konservs/esp-resso/docs/hardware.md

# Hardware

> ⚠️ This machine runs on **mains voltage** and holds **pressurised boilers near
> steam temperature**. Read [safety.md](safety.md) before wiring anything. The
> firmware is a *secondary* safety layer, never the only one.

## Overview

A dual-boiler E61 machine:

- **Brew boiler** (~93 °C) — espresso extraction.
- **Steam boiler** (~125 °C) — steam wand / hot water.
- **E61 group** — the lever mechanically opens the 3-way valve and trips a
  microswitch; the firmware does **not** drive a group valve.

## Bill of materials (core electronics)

| Qty | Part | Notes |
|----:|---|---|
| 1 | ESP32 dev module (WROOM-32) | Dual-core, classic ESP32 |
| 2 | MAX31865 RTD amplifier | One per boiler; 400 Ω precision reference for PT100 (`RTD_RREF` in `hal_esp32_temp.c` must match) |
| 2 | PT100 RTD probe | M4/M5 threaded or clamp, boiler temperature. **3-wire** — the firmware configures the MAX31865 to match (`RTD_WIRES` in `hal_esp32_temp.c`), and the board's RTDIN/FORCE jumpers must agree |
| 4 | Solid-state relay (zero-cross) | Boiler heaters — **two per boiler** (lower + upper element, ~400 W each), slow-PWM; DC-input, driven at 12 V via the ULN2003. Firmware runs at most 3 at once on a 120 V/15 A circuit — see the load guard in [control.md](control.md) |
| 1 | Pump + zero-cross SSR | **Ulka EFX5** vibratory (rated 2 min ON / 1 min OFF — firmware enforces the duty cycle, see [control.md](control.md)); zero-cross SSR enables pulse-skip flow. A rotary pump also fits — size the SSR for motor inrush |
| 2 | Mains solenoid valve (230/120 VAC) | Brew / steam auto-fill inlets; OEM Olab type (e.g. Profitec US1005) |
| 2 | 12 V relay (PCB, ≥ 250 VAC) | Switch each fill solenoid; optional RC/MOV across contacts |
| 1 | ULN2003A Darlington array | One low-side buffer for all actuators: 5 SSR inputs (4 heater elements + pump) + 2 relay coils = all 7 channels; COM→+12 V flyback |
| 1 | Flow meter (Hall, e.g. digmesa/gicar) | Volumetric dosing |
| 2 | Conductivity level probe | Brew + steam boilers (isolated AC-sensed) |
| 1 | Float switch | Reservoir low-water (reed/magnet) |
| 1 | 12 V DC PSU (≥ 1 A) | Main supply; logic + sensing + relay coils (fill valves are mains, relay-switched) — see [power.md](power.md) |
| 1 | Buck regulator 12→5 V | e.g. AP63205 / MP1584 — efficient bulk drop |
| 1 | LDO 5→3.3 V | e.g. AP2112K-3.3 — low-noise rail for ESP32 + RTDs |
| 1 | Isolated dual ±12 V DC-DC | e.g. Murata NMA1212 — **+12VA / GNDA / −12VA** for sensing (separate ground) |
| 1 | 74HC139 decoder | SELECT/ENABLE/REVERSE → 4 switch drives + shoot-through interlock (MCU side) |
| 1 | 74HC157 mux | SELECT routes active boiler's POS/NEG sense → 2 MCU pins (MCU side) |
| 8 | Optocoupler (PC817, V(CEO) ≥ 24 V) | 4× drive — decoder out, the opto *is* the ±12VA switch (no MOSFET) — + 4× sense (per boiler, per direction) |
| — | Current-limit resistors | ~4.7 kΩ per boiler (≈1–2 mA); see level-sensing.md |
| 1 | SSD1306 OLED, 128×64, I2C | Status display, address 0x3C |
| 1 | PCF8574 I2C expander | All buttons + switches (address 0x20); frees JTAG pins |
| 2 | Momentary push button | UI (A = −/left, B = +/right), to PCF8574 P0/P1 |
| 2 | Microswitch | E61 brew lever, steam knob, to PCF8574 P2/P3 |
| — | Thermal fuses, over-pressure valve | **Hardware** safety — see safety.md |

## GPIO map

Defined in [`components/drivers/include/drivers/pins.h`](../components/drivers/include/drivers/pins.h).
Change wiring there.

| Function | GPIO | Notes |
|---|-----:|---|
| SPI SCLK | 18 | Shared by both MAX31865 |
| SPI MOSI | 23 | |
| SPI MISO | 19 | |
| RTD brew CS | 5 | |
| RTD steam CS | 15 | Strapping pin, but CS idles high → boot-safe |
| I2C SDA | 21 | Shared: SSD1306 + PCF8574 |
| I2C SCL | 22 | Shared: SSD1306 + PCF8574 |
| SSR brew low | 26 | Active-high → ULN2003 → brew lower-element SSR; **R10** 10 kΩ pulldown |
| SSR brew high | 33 | Active-high → ULN2003 → brew upper-element SSR; **R22** 10 kΩ pulldown |
| SSR steam low | 25 | Active-high → ULN2003 → steam lower-element SSR; **R9** 10 kΩ pulldown |
| SSR steam high | 32 | Active-high → ULN2003 → steam upper-element SSR; **R17** 10 kΩ pulldown |
| Pump | 27 | Active-high → ULN2003 → pump SSR; **R16** 10 kΩ pulldown |
| Fill valve (brew) | 13 | Active-high → ULN2003 → fill relay; **R23** 10 kΩ pulldown |
| Fill valve (steam) | 4 | Active-high → ULN2003 → fill relay; **R24** 10 kΩ pulldown, and GPIO4 idles pulled-down internally → valve shut at boot |
| Flow meter | 34 | **Input-only**, needs external pull-up |
| Level SELECT | 16 | boiler select → 74HC139 A1 + 74HC157 sel |
| Level ENABLE | 17 | drive enable → 74HC139 Ē (active-low); **R11** 4.7 kΩ pull-up → drive idle-off at boot |
| Level REVERSE | 14 | polarity → 74HC139 A0; idles high at reset, harmless because R11 gates the decoder |
| Level sense + | 35 | **Input-only**, 74HC157 out (POS opto) |
| Level sense − | 36 | **Input-only**, 74HC157 out (NEG opto) |
| Level — reservoir | 39 | **Input-only**, float switch, external pull-up |

The UI buttons (A/B) and machine switches (brew lever, steam knob) are **not**
on native GPIOs — they hang off the PCF8574 I2C expander (below), which freed up
native pins. **GPIO 16/17/14** carry the level control lines
(SELECT/ENABLE/REVERSE); **GPIO 33** and **GPIO 32** drive the two upper
heater-element SSRs; the steam fill valve has **GPIO 4**. That leaves **GPIO 2**
(a strapping pin) as the only spare. (JTAG is not wired — see
[level-sensing.md](level-sensing.md).)

Pin choices here are driven as much by **reset pull state** as by function, since
every actuator is active-high through the ULN2003: GPIO 14/15 idle pulled *up*,
GPIO 2/4/12 idle pulled *down*, and 13/16/17/25/26/27/32/33 float. So the steam
fill valve sits on GPIO 4 (pulled down = shut at boot), while GPIO 14 — which
idles high — carries only level REVERSE, a logic input the decoder ignores while
R11 holds it disabled. See the caveats below.

### I2C input expander (PCF8574, address 0x20)

Eight active-low inputs on one chip, read over I2C alongside the OLED. Each pin
idles high on the expander's weak pull-up; the contact wires to GND. Bit map
lives in [`pins.h`](../components/drivers/include/drivers/pins.h) (`EXP_*`).

| Expander pin | Input | Notes |
|---|---|---|
| P0 | Button A (−) | UI left / minus |
| P1 | Button B (+) | UI right / plus |
| P2 | Brew lever switch | E61 paddle microswitch |
| P3 | Steam knob switch | Steam valve microswitch |
| P4–P7 | *spare* | Free for future buttons |

For more than 8 inputs, add a second expander at a different address.

### ESP32 pin caveats baked into the choices

- GPIO **34/35/36/39** are input-only and have **no internal pull resistors**, so
  any *passive* source on them needs an external pull. That applies to the flow
  meter (**R12**, 4.7 kΩ → 3.3 V) and the reservoir float switch (**R15**,
  4.7 kΩ → 3.3 V), both of which just close to GND. It does **not** apply to the
  level sense lines: GPIO 35/36 are fed by the 74HC157's push-pull CMOS outputs
  and are actively driven both ways. The 47 kΩ sense pull-ups (**R19/R18** brew,
  **R21/R20** steam) belong one stage earlier, on the opto collectors that feed the
  mux — see [level-sensing.md](level-sensing.md), where the value is set by
  sense-opto CTR rather than by anything the MCU needs.
- GPIO **0/2/5/12/15** are strapping pins and are avoided as driven outputs.
  GPIO 5 and 15 are used only as chip-selects (idle high), which is safe at boot.
  **GPIO 12**
  additionally selects the module's flash voltage and must be **low at reset**: it
  is left as a no-connect (the chip's internal pull-down holds it low → 3.3 V
  flash); an optional ~10 kΩ pull-down to GND adds margin. Never pull GPIO 12 high.
- **WROOM-32 module flash pins** — `SCK/SDO/SDI/SHD/SWP/SCS` (GPIO 6–11) are the
  module's internal SPI-flash bus, bonded to the flash die inside the can. **Leave
  them unconnected** (no-connect flags in the schematic, as verified); do not tie
  them to GND or route them anywhere, or the module won't boot / the flash can
  corrupt.
- **Every ULN2003 input carries a 10 kΩ pulldown to GND** — R9/R10/R17/R22
  (heaters), R16 (pump), R23/R24 (fill valves). These are not optional. The
  firmware only drives these pins low once `espresso_hal_init()` reaches the
  actuator init, which is several hundred milliseconds after reset (ROM
  bootloader → `app_main` → storage and temp init first). Until then the
  resistors alone decide whether a heater, the pump, or a fill valve is
  energised.
- GPIO **14** idles with a weak **internal pull-up** at reset, so no active-high
  load may sit on it. It carries level **REVERSE**, where idling high is harmless:
  the 74HC139 is held disabled by R11, so no rod is driven regardless of polarity.
  Nothing on this pin needs a pulldown.
- The **level drive** relies on **R11** (4.7 kΩ pull-up on `LEVEL_ENABLE`) to keep
  the 74HC139 disabled from reset until `hal_level_init()` runs — GPIO 17 floats,
  and the decoder enable is active-low, so without R11 a rod could be energised at
  boot. Do not remove it.
- The shared I2C bus **needs external pull-ups on SDA/SCL, and the board does
  not carry any** — nothing but the ESP32 pad and J8 sits on those two nets.
  Do not rely on a breakout module bringing its own. The ESP32's internal
  pull-ups are ~45 kΩ, which is far too weak here: against the ~50 pF of a short
  cable that is already a ~1.9 µs rise time, against the I2C limit of 300 ns at
  400 kHz. The panel comes up, then smears or drops out as the bus loads.
  Fit **2.2 kΩ** to 3.3 V on each line (3.3 kΩ if the run is short). At 3.3 V
  that is 1.5 mA per line, comfortably inside the 3 mA both the SSD1306 and the
  PCF8574 are specified to sink. The firmware still enables the internal
  pull-ups; in parallel they neither help nor hurt.
- **J8's pinout is poor for a long cable.** It is `3V3 / NC / SDA / SCL / GND`,
  so SDA and SCL are neighbours with no ground between them and only one ground
  at the far end — every SCL edge couples into SDA. Pin 2 is a genuine
  no-connect, so jumper it to GND and wire the cable as
  `3V3 / GND / SDA / SCL / GND`; better still, run SDA and SCL as separate
  twisted pairs each with its own ground. Give the remote end its own 100 nF +
  10 µF across 3V3/GND — the OLED charge pump is a pulsed load at the end of a
  long, inductive feed. **Note the caps go across the rail, never on a signal
  line**: 100 nF from SDA to GND is a dead bus.
- A jammed bus is recovered in firmware, not by a power cycle — see
  [`i2c_bus.h`](../components/drivers/include/drivers/i2c_bus.h). A driver that
  keeps failing asks for escalating recovery: first a soft reset (peripheral FSM
  reset plus nine clock pulses to walk a stuck slave off SDA), then a full
  teardown and rebuild with each chip re-initialised. Attempts are paced and
  back off, so an unplugged cable costs one attempt every few seconds rather
  than one per UI frame.

## Power

The board runs from a single **12 V DC** input (**+12V** / **GND**); the heaters,
pump, and fill solenoids are all mains loads (the heaters and pump switched via
SSR, the fill valves via 12 V relays — all buffered by one ULN2003, never powered
here). A **buck**
drops 12 V → 5 V efficiently, then a low-noise **LDO** drops 5 V → 3.3 V for the
ESP32 and the RTD front-ends — two stages keep the 3.3 V rail quiet without
cooking a linear regulator (a single 12 V → 3.3 V LDO would dissipate ~1.7 W).
The level-sensing drive runs on a **separate isolated dual rail, +12VA / GNDA /
−12VA** (do not merge **GNDA** with logic **GND**).

Continuous electronics draw is ≈ **1.5 W** (the ESP32 dominates); the mains loads
only present their ULN2003 drive currents on +12 V (~12 mA per SSR input ×5, ~35 mA
per relay coil ×2 — ≈130 mA total), so a **12 V / 1 A** supply is still enough.

Full rail tree, recommended chips (buck / LDO / isolated DC-DC), decoupling and
protection, and the per-rail power budget: **[power.md](power.md)**.

## Brew-boiler-only builds

The steam side can be left unpopulated. Clear **Steam boiler fitted** in
`menuconfig` (`CONFIG_ESPRESSO_STEAM_BOILER`; the committed `sdkconfig.defaults`
currently has it off for bench work). The firmware then never initialises or
reads the steam MAX31865, never drives the steam heaters, fill valve or level
probe, ignores the steam knob, and the safety supervisor does not require a
steam temperature. READY needs only the brew boiler at setpoint.

## Sensing details

- **Temperature:** 3-wire PT100 over MAX31865 (SPI, mode 1). The wiring mode is
  set per device in `hal_esp32_temp.c` and **must match what is soldered**: a
  3-wire probe read in 2-wire mode reports a permanent open-circuit fault on
  every read. Resistance→temperature
  conversion is the portable `core/rtd.c` (Callendar–Van Dusen), unit-tested on
  the host. Sensor open/short is reported via the MAX31865 fault bit and becomes
  a safety trip. A **near-zero or absurd resistance** — an absent/silent
  front-end whose registers read all-zero, which would otherwise convert to a
  plausible-looking ~−247 °C — is also rejected (plausibility band in
  `rtd.c`) and reported as a sensor fault rather than trusted.
- **Flow:** Hall flow meter on a pulse counter (`pulse_cnt`). Calibrate
  `FLOW_PULSES_PER_ML` in `hal_esp32_sensors.c` against a measured pour.
- **Level:** boiler rods use **opto-isolated bipolar ±12 V conductivity sensing**.
  SELECT/ENABLE/REVERSE feed a 74HC139 decoder whose four outputs each light a
  drive optocoupler; the opto's own transistor switches **one** rod at a time to
  +12 V then −12 V vs. the earthed body (probe current ~1–2 mA, so no MOSFET is
  needed; zero net DC, so no electrolysis). Per-boiler, per-direction optos
  report conduction; a 74HC157 (SELECT) routes the active boiler's POS/NEG onto
  two inputs. Real water conducts **both** ways in step with the drive, checked at
  two frequencies for noise rejection. Isolation keeps boiler/mains noise off the
  ESP32. The control loop debounces the result and drives auto-fill. The reservoir
  uses a float switch. Full circuit and rationale: **[level-sensing.md](level-sensing.md)**.

## Not in v1 (future)

- **Pressure transducer / pressure profiling** — deliberately omitted for now;
  the brew controller stops on volume + time. The brew stage model already has a
  `BREW_PUMP_PRESSURE` mode reserved for when a sensor is added.
