konservs/esp-resso/main/app_main.c

/**
 * @file app_main.c
 * @brief Firmware entry point: bring up hardware, load settings, wire the
 *        portable core to the HAL, and start the FreeRTOS tasks.
 */
#include "app.h"

#include "esp_log.h"
#include "freertos/FreeRTOS.h"
#include "freertos/task.h"
#include "nvs_flash.h"

#include "hal/hal.h"
#include "hal/hal_display.h"
#include "hal/hal_input.h"
#include "hal/hal_level.h"
#include "hal/hal_storage.h"
#include "hal/hal_time.h"

static const char *TAG = "app";

app_state_t g_app;

void app_post_event(machine_event_t ev)
{
    if (g_app.events != NULL) {
        (void)xQueueSend(g_app.events, &ev, 0);
    }
}

void app_get_telemetry(app_telemetry_t *out)
{
    xSemaphoreTake(g_app.lock, portMAX_DELAY);
    out->state = machine_state(&g_app.machine);
    out->safety_trip = safety_trip(&g_app.safety);
    out->brew_temp = g_app.brew_temp.celsius;
    out->steam_temp = g_app.steam_temp.celsius;
    out->brew_setpoint = g_app.settings.brew_setpoint;
    out->steam_setpoint = g_app.settings.steam_setpoint;
    out->brew_sensor_ok = g_app.brew_temp.ok;
    out->steam_sensor_ok = g_app.steam_temp.ok;
    out->brew_temp_fault = g_app.brew_temp.fault;
    out->steam_temp_fault = g_app.steam_temp.fault;
    out->brew_duty = g_app.brew_duty;
    out->steam_duty = g_app.steam_duty;
    out->both_ready = g_app.both_ready;
    out->shot_volume_ml = g_app.shot_volume_ml;
    out->shot_elapsed_ms = g_app.shot_elapsed_ms;
    out->flow_rate_ml_s = g_app.flow_rate_ml_s;
    out->pump_cooling = g_app.pump_cooling;
    out->pump_cooldown_ms = g_app.pump_cooldown_ms;
    out->brew_level = g_app.brew_level;
    out->steam_level = g_app.steam_level;
    out->reservoir_ok = g_app.reservoir_present;
    out->valve_brew_open = g_app.valve_brew_open;
    out->valve_steam_open = g_app.valve_steam_open;
    out->debug_out = g_app.debug_out;
    out->debug_ms = g_app.debug_ms;
    xSemaphoreGive(g_app.lock);

    /* Component health from the HAL (cached flags, no bus traffic). */
    out->display_ok = hal_display_ok();
    out->buttons_ok = hal_input_ok();

    /* Raw button/switch states: lock-free atomics published by the UI task. */
    out->button_a = atomic_load(&g_app.button_a);
    out->button_b = atomic_load(&g_app.button_b);
    out->switch_brew = atomic_load(&g_app.switch_brew);
    out->switch_steam = atomic_load(&g_app.switch_steam);
}

app_pulse_result_t app_debug_pulse(debug_out_t out)
{
    app_pulse_result_t rc = APP_PULSE_OK;

    xSemaphoreTake(g_app.lock, portMAX_DELAY);
    if (out == DEBUG_OUT_NONE) {
        debug_pulse_stop(&g_app.debug_pulse); /* explicit cancel is always allowed */
    } else if (!debug_pulse_permitted(machine_state(&g_app.machine))) {
        rc = APP_PULSE_REFUSED;
    } else if (!debug_pulse_start(&g_app.debug_pulse, out, hal_time_ms(),
                                  DEBUG_PULSE_MS)) {
        rc = APP_PULSE_BAD_OUTPUT;
    }
    xSemaphoreGive(g_app.lock);

    if (rc == APP_PULSE_OK) {
        ESP_LOGW(TAG, "debug pulse: %s for %u ms", debug_pulse_out_name(out),
                 (unsigned)(out == DEBUG_OUT_NONE ? 0u : DEBUG_PULSE_MS));
    }
    return rc;
}

/* Load persisted settings, falling back to validated defaults. */
static void load_settings(settings_t *s)
{
    settings_load_defaults(s);

    settings_t stored;
    if (hal_storage_load("settings", &stored, sizeof(stored)) == ESPRESSO_OK &&
        settings_validate(&stored) == ESPRESSO_OK) {
        *s = stored;
        ESP_LOGI(TAG, "loaded settings from NVS");
    } else {
        ESP_LOGW(TAG, "using default settings");
    }
}

void app_apply_brew_profile(app_state_t *app)
{
    brew_profile_t profile;
    brew_profile_build(&profile, app->settings.active_profile, &app->settings.brew);
    brew_init(&app->brew, &profile);
}

static void init_controllers(app_state_t *app)
{
    const settings_t *s = &app->settings;
    boiler_init(&app->brew_boiler, s->brew_setpoint, &s->brew_pid, 1.0f);
    boiler_init(&app->steam_boiler, s->steam_setpoint, &s->steam_pid, 2.0f);
    app_apply_brew_profile(app);
    pump_guard_init(&app->pump_guard, &s->pump);
    debug_pulse_init(&app->debug_pulse);
    safety_init(&app->safety, &s->safety);
    machine_init(&app->machine);
}

void app_main(void)
{
    ESP_LOGI(TAG, "ESP.Resso starting");

    /* NVS must be ready before Wi-Fi or settings storage. */
    esp_err_t nvs = nvs_flash_init();
    if (nvs == ESP_ERR_NVS_NO_FREE_PAGES || nvs == ESP_ERR_NVS_NEW_VERSION_FOUND) {
        ESP_ERROR_CHECK(nvs_flash_erase());
        ESP_ERROR_CHECK(nvs_flash_init());
    }

    /* HAL bring-up degrades gracefully: each subsystem logs its own failure and
     * we continue booting (see hal_esp32.c). A missing display or input expander
     * must not stop the machine — the safety supervisor still trips the heaters
     * on a sensor fault at runtime, which is the real fail-safe. */
    if (espresso_hal_init() != ESPRESSO_OK) {
        ESP_LOGW(TAG, "HAL init reported failures; continuing (see errors above)");
    }

    g_app.lock = xSemaphoreCreateMutex();
    g_app.events = xQueueCreate(16, sizeof(machine_event_t));
    configASSERT(g_app.lock && g_app.events);

    load_settings(&g_app.settings);
    init_controllers(&g_app);

    /* Start both boiler levels UNKNOWN: until the level task publishes a fresh
     * reading, control treats them as untrusted (heaters off, fill valve shut). */
    atomic_init(&g_app.brew_probe_state, HAL_LEVEL_UNKNOWN);
    atomic_init(&g_app.steam_probe_state, HAL_LEVEL_UNKNOWN);
    atomic_init(&g_app.level_update_ms, 0);

    /* Priorities: safety highest, then control, then level sensing, then UI/net.
     * Control + safety are pinned to core 1 to keep timing away from the
     * Wi-Fi/IDF housekeeping that tends to live on core 0. The level task sits on
     * core 0 too, so its few-ms probe bursts never steal time from control. */
    xTaskCreatePinnedToCore(safety_task,  "safety",  3072, NULL, 6, NULL, 1);
    xTaskCreatePinnedToCore(control_task, "control", 4096, NULL, 5, NULL, 1);
    xTaskCreatePinnedToCore(level_task,   "level",   3072, NULL, 4, NULL, 0);
    xTaskCreatePinnedToCore(ui_task,      "ui",      4096, NULL, 3, NULL, 0);
    xTaskCreatePinnedToCore(net_task,     "net",     4096, NULL, 2, NULL, 0);

    app_post_event(EV_WAKE);
}
