konservs/esp-resso/main/include/app.h

/**
 * @file app.h
 * @brief Shared application context and task entry points.
 *
 * The firmware is organised as a small set of FreeRTOS tasks that share one
 * @ref app_state_t guarded by a mutex, and communicate machine transitions
 * through an event queue. The tasks own all RTOS concerns; the decision logic
 * they call lives in the portable @c core library.
 */
#ifndef ESPRESSO_APP_H
#define ESPRESSO_APP_H

#include <stdatomic.h>

#include "sdkconfig.h"

#include "freertos/FreeRTOS.h"
#include "freertos/queue.h"
#include "freertos/semphr.h"

#include "core/boiler.h"
#include "core/brew.h"
#include "core/debug_pulse.h"
#include "core/pump_guard.h"
#include "core/safety.h"
#include "core/settings.h"

/* Steam boiler fitted? (menuconfig: ESP.Resso -> "Steam boiler fitted"). When 0
 * the steam side does not exist to the firmware: no RTD read, no heater, fill
 * or level drive, the steam knob is ignored and the safety supervisor does not
 * require a steam temperature. See the Kconfig help text. */
#ifdef CONFIG_ESPRESSO_STEAM_BOILER
#define STEAM_ENABLED 1
#else
#define STEAM_ENABLED 0
#endif
#include "core/state_machine.h"
#include "hal/hal_level.h"
#include "hal/hal_temp.h"

/**
 * @brief What a boiler's level probe reports — and nothing else.
 *
 * Deliberately free of every other consideration: the reservoir, the machine
 * state, whether a fill is running. Those are separate facts with their own
 * fields (::app_telemetry_t::reservoir_ok, ::app_telemetry_t::valve_brew_open),
 * and folding them in here is what once made an *empty reservoir* display as a
 * *failed level sensor* — two unrelated problems wearing the same red label.
 *
 * Nothing that acts on water level reads this. The dry-fire interlock and the
 * auto-fill decision work from the probe states (::app_state_t::brew_probe_state)
 * directly, so this stays a report and never becomes a control input.
 */
typedef enum {
    LVL_INIT = 0,  /**< No settled reading yet — the first moments after boot. */
    LVL_FULL,      /**< Probe covered.                                        */
    LVL_EMPTY,     /**< Probe uncovered.                                      */
    LVL_ERROR,     /**< Sense path faulted: POS and NEG both conducting.      */
    LVL_STALE      /**< The level task has stopped publishing readings.       */
} level_status_t;

/** Control-loop period. Boiler PIDs and the brew controller run at this rate. */
#define CONTROL_PERIOD_MS 100
/** Safety supervisor period (runs faster, at higher priority). */
#define SAFETY_PERIOD_MS  50
/** Display refresh period. */
#define UI_PERIOD_MS      125
/** Water-level sensing period. The level task owns the probe drive lines and
 *  publishes debounced state to the control loop, so its cadence is independent
 *  of CONTROL_PERIOD_MS and can be retuned (e.g. slowed for bench debugging)
 *  without touching control timing. */
#define LEVEL_PERIOD_MS   100
/** A published boiler level older than this (the level task stalled or died) is
 *  treated as untrusted: that boiler's heaters stay off and its fill valve shut
 *  until a fresh reading arrives. */
#define LEVEL_STALE_MS    10000
/** A published temperature older than this means the control loop has stalled
 *  or died, so its last reading can no longer be trusted. The safety supervisor
 *  treats that as a sensor fault. Ten control periods. */
#define TEMP_STALE_MS     1000

/** Shared machine state. Hold @ref app_state_t::lock when touching it. */
typedef struct {
    settings_t settings;
    machine_t  machine;
    boiler_t   brew_boiler;
    boiler_t   steam_boiler;
    brew_t     brew;
    pump_guard_t pump_guard;
    safety_t   safety;
    /** Admin bench override of one actuator (see core/debug_pulse.h). Started
     *  from the dashboard, expired by the control loop. */
    debug_pulse_t debug_pulse;

    /* Live telemetry published by the control task (for UI / safety / net). */
    hal_temp_reading_t brew_temp;
    hal_temp_reading_t steam_temp;
    /** When the control loop last published the two readings above. 0 until its
     *  first sample: the safety supervisor runs sooner, and must not read the
     *  zero-initialised placeholders as a faulted probe (see ::TEMP_STALE_MS). */
    esp_ms_t temp_update_ms;
    float    brew_duty;
    float    steam_duty;
    bool     heater_active[LOAD_HEATER_COUNT]; /**< Per-element drive state after
                                                *   the load guard (::load_heater_t
                                                *   order); for the UI indicators. */
    float    shot_volume_ml;
    uint32_t shot_elapsed_ms;
    float    flow_rate_ml_s;   /**< Live flow rate (smoothed), ml/s.          */
    bool     both_ready;
    bool     pump_cooling;     /**< Pump duty-cycle guard is resting.         */
    uint32_t pump_cooldown_ms; /**< Rest remaining before a shot can start.   */

    /* Water-level diagnostics published by the control task. */
    level_status_t brew_level;
    level_status_t steam_level;
    bool     reservoir_present;
    bool     valve_brew_open;  /**< Brew auto-fill solenoid commanded open.   */
    bool     valve_steam_open; /**< Steam auto-fill solenoid commanded open.  */
    debug_out_t debug_out;     /**< Output the debug pulse is driving, if any. */
    uint32_t debug_ms;         /**< Milliseconds left on that pulse.           */

    /* Lock-free inter-task signals — the one exception to the "hold @ref lock"
     * rule below. Each has a single writer and a single reader and is
     * non-critical for a torn read, so it is published/read as an atomic rather
     * than under the mutex.
     * Buttons/switches: written by the UI task, read by telemetry. */
    _Atomic bool button_a;     /**< Button A (left / minus) pressed now.      */
    _Atomic bool button_b;     /**< Button B (right / plus) pressed now.      */
    _Atomic bool switch_brew;  /**< E61 brew lever engaged now.               */
    _Atomic bool switch_steam; /**< Steam knob engaged now.                   */
    /* Debounced conductivity-probe state + its publish time: written by the
     * level task at its own cadence (::LEVEL_PERIOD_MS), read by the control
     * loop for the dry-fire interlock and auto-fill. Seeded to
     * ::HAL_LEVEL_UNKNOWN at boot (see app_main); control distrusts a probe that
     * is UNKNOWN or whose timestamp is older than ::LEVEL_STALE_MS, holding that
     * boiler's heaters off and fill valve shut until a fresh reading arrives. */
    _Atomic hal_level_state_t brew_probe_state;
    _Atomic hal_level_state_t steam_probe_state;
    _Atomic esp_ms_t          level_update_ms;

    SemaphoreHandle_t lock;   /**< Guards this struct.               */
    QueueHandle_t     events; /**< machine_event_t produced by tasks. */
} app_state_t;

/** The single global application context. */
extern app_state_t g_app;

/** Immutable snapshot of live state, for the UI and the Wi-Fi dashboard. */
typedef struct {
    machine_state_t state;
    safety_trip_t   safety_trip;
    temp_c_t brew_temp;
    temp_c_t steam_temp;
    temp_c_t brew_setpoint;
    temp_c_t steam_setpoint;
    bool     brew_sensor_ok;
    bool     steam_sensor_ok;
    uint8_t  brew_temp_fault;  /**< MAX31865 fault byte when !brew_sensor_ok.  */
    uint8_t  steam_temp_fault; /**< MAX31865 fault byte when !steam_sensor_ok. */
    float    brew_duty;
    float    steam_duty;
    bool     both_ready;
    float    shot_volume_ml;
    uint32_t shot_elapsed_ms;
    float    flow_rate_ml_s;   /**< Live flow rate (smoothed), ml/s. */

    /* Pump duty-cycle guard: resting (can't brew) + remaining cooldown. */
    bool     pump_cooling;
    uint32_t pump_cooldown_ms;

    /* Component self-check for the diagnostics view. */
    bool           display_ok;
    bool           buttons_ok;
    bool           button_a;    /**< Button A (left / minus) pressed now.  */
    bool           button_b;    /**< Button B (right / plus) pressed now.  */
    bool           switch_brew; /**< E61 brew lever engaged now.           */
    bool           switch_steam;/**< Steam knob engaged now.               */
    level_status_t brew_level;
    level_status_t steam_level;
    bool           reservoir_ok;
    bool           valve_brew_open;  /**< Brew auto-fill solenoid open.  */
    bool           valve_steam_open; /**< Steam auto-fill solenoid open. */
    debug_out_t    debug_out;        /**< Output a debug pulse is driving. */
    uint32_t       debug_ms;         /**< Milliseconds left on that pulse. */
} app_telemetry_t;

/** Why ::app_debug_pulse refused to start a pulse. */
typedef enum {
    APP_PULSE_OK = 0,
    APP_PULSE_BAD_OUTPUT, /**< Not an output a debug pulse may drive.       */
    APP_PULSE_REFUSED     /**< Safety tripped, or a shot/backflush running. */
} app_pulse_result_t;

/**
 * @brief Drive one actuator directly for ::DEBUG_PULSE_MS, for bench testing.
 *
 * Admin-only from the dashboard. Takes the lock internally, and only starts a
 * pulse when ::debug_pulse_permitted agrees; the control loop expires it, so
 * the output cannot stay on if the caller goes away. Passing
 * ::DEBUG_OUT_NONE cancels a running pulse.
 */
app_pulse_result_t app_debug_pulse(debug_out_t out);

/** Post a machine event from any task/ISR-safe context. */
void app_post_event(machine_event_t ev);

/** Copy a consistent snapshot of live state (takes the lock internally). */
void app_get_telemetry(app_telemetry_t *out);

/** Rebuild the brew controller from the current settings (profile + params).
 *  Caller must hold @ref app_state_t::lock. */
void app_apply_brew_profile(app_state_t *app);

/** Clear saved Wi-Fi credentials and reboot into the SoftAP setup portal.
 *  Safe to call from any task; a no-op when Wi-Fi is disabled at build time. */
void net_request_provisioning(void);

/* Task entry points (created in app_main). */
void control_task(void *arg);
void safety_task(void *arg);
void ui_task(void *arg);
void net_task(void *arg);
void level_task(void *arg);

#endif /* ESPRESSO_APP_H */
