konservs/esp-resso/components/drivers/src/hal_esp32_input.c

/**
 * @file hal_esp32_input.c
 * @brief The two UI buttons and the brew/steam control switches.
 *
 * All four inputs now live on a PCF8574 I2C expander (freeing native GPIOs
 * 13/14/15 for JTAG — see docs/hardware.md). Each is wired active-low to GND;
 * the expander's weak pull-ups hold an open contact high. Reads are raw: the UI
 * task polls slowly (~125 ms), which filters mechanical bounce, and
 * core/buttons interprets gestures from there.
 *
 * The whole 8-bit port arrives in one transfer, so ::hal_input_poll takes that
 * one snapshot per cycle and the accessors just decode bits out of it. That
 * keeps a cycle's view of the inputs self-consistent, and keeps one polling
 * cycle to a single I2C transaction — on a long bus, three separate reads is
 * three times the chance of catching a glitch and, when the bus is jammed,
 * three times the stall. The last good value is cached, so a transient NAK
 * reports the previous state rather than a phantom press.
 *
 * Spare expander bits (P4..P7) are free for future buttons.
 */
#include "hal/hal_input.h"

#include "drivers/pcf8574.h"
#include "drivers/pins.h"

/* Idle (nothing pressed) is all-high, since inputs are active-low. */
static uint8_t s_port = 0xFF;
static bool s_ok; /* whether the last expander read/init succeeded */

espresso_result_t hal_input_init(void)
{
    s_ok = (pcf8574_init(PCF8574_I2C_ADDR) == ESP_OK);
    return s_ok ? ESPRESSO_OK : ESPRESSO_ERR_STATE;
}

bool hal_input_ok(void)
{
    return s_ok;
}

void hal_input_poll(void)
{
    /* On an I2C error pcf8574_read leaves s_port alone, so the snapshot keeps
     * the last good sample and the UI holds still instead of jittering. */
    s_ok = (pcf8574_read(&s_port) == ESP_OK);
}

/* Active-low: a pressed/engaged contact pulls its expander pin to 0. */
static bool pressed(int bit)
{
    return ((s_port >> bit) & 0x01) == 0;
}

hal_buttons_t hal_buttons_read(void)
{
    hal_buttons_t b;
    b.a = pressed(EXP_BTN_A);
    b.b = pressed(EXP_BTN_B);
    return b;
}

bool hal_switch_brew(void)
{
    return pressed(EXP_SWITCH_BREW);
}

bool hal_switch_steam(void)
{
    return pressed(EXP_SWITCH_STEAM);
}
