konservs/esp-resso/(commit log)

2026-06-26 Initial commit, added all logic, tasks, tests
    [partitions.csv]
2026-06-27 Moving buttons into I²C bus
2026-06-28 SSID initial configuration fix
    [i2c_bus.c, net_task.c]
2026-06-28 Continue and halt instead of reboot
    [app_main.c]
2026-06-29 Added sensor details
2026-06-29 Started working on a PCB
    [espresso.kicad_pcb, espresso.kicad_sch]
2026-07-04 Finalized water level sensing, PCB is almost done
    [espresso.kicad_pcb, espresso.kicad_sch]
2026-07-10 Finalizing PCB, added load and pump guards
    [espresso.kicad_pcb, espresso.kicad_sch]
2026-07-10 Added display simulator, small dispalay fixes
    [hal_esp32_display.c, net_task.c, pins.h, ui_task.c]
2026-07-10 PCB level sensing improvements, added sensing failure checks and water level guard
    [espresso.kicad_pcb, espresso.kicad_sch]
2026-07-13 Added flow and solenoid states
2026-07-27 Fixed UI, remapped buttons, added button debugging circles
    [espresso.kicad_pcb, espresso.kicad_sch]
2026-09-11 Improved small things
    [esp-resso-control.kicad_pcb, esp-resso-control.kicad_sch, espresso.kicad_pcb, espresso.kicad_sch]
2026-10-26 Small fixes with guards, de-bouncing temperature probes
